noderockets/noderocket.org/README.md

# Your [DocPad](http://docpad.org) Project

## License
Copyright &copy; 2014+ All rights reserved.
