noderockets/noderocket.org/src/documents/rocket_control.html.md

---
title: "Node Rockets Rocket Control System"
layout: "default"
isPage: true
---

Rocket Control System
=======================

Goals
-----

The goals for the rocket control system are to:

1. Measure the altitude of the rocket.
2. Release a parachute.

Plans
-----

We're going to use a [BMP-180 module](http://www.adafruit.com/products/1603) to measure the altitude.  It's a barometric pressure sensor and altimeter.  The parachute will be released by turning a small servo motor.  Each of these components will be wired up to the Raspberry Pi's GPIO pins.

GPIO Pins
---------

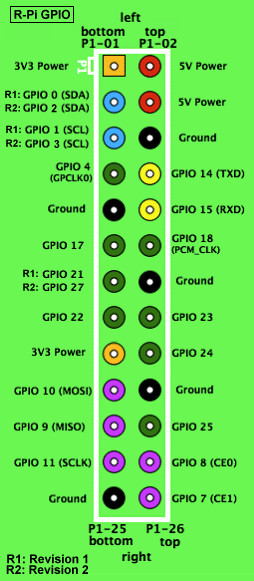
[picture p16: src/files/images/GPIOs.png]
Raspberry Pi GPIO Pins


The raspberry pi GPIO pins are laid out as shown above.  Numbering can be confusing, because it seems like different documents number the pins in different ways.  This diagram labels the entire GPIO header as P1, and numbers the pins on the left with odd numbers 1-25 and the pins on the right with even numbers 2-26.

Altimeter
---------

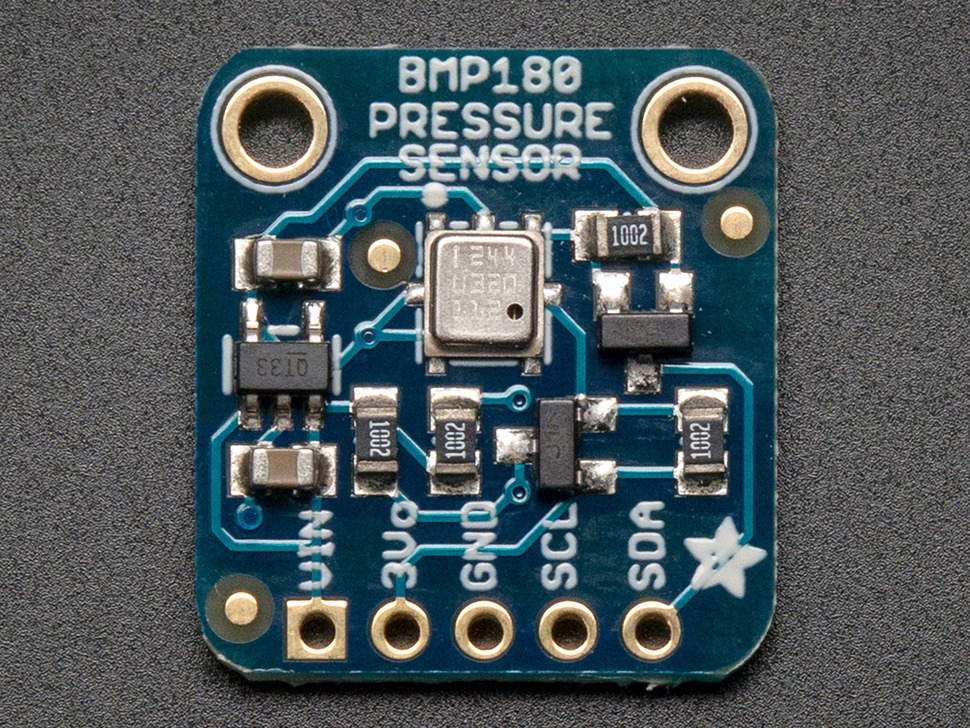
[picture p17: src/files/images/bmp180.jpg]
BMP-180


The BMP-180 uses [the I2C protocol](http://en.wikipedia.org/wiki/I%C2%B2C).  This protocol requires 4 connections: VIN (power), GND (ground), SCL (clock), and SDA (data).  The BMP-180 pins should be connected to these GPIO pins:

| BMP-180 | | GPIO |
|:---:| - |:----:|
| VIN | | 4 |
| GND | | 6 |
| SCL | | 5 |
| SDA | | 3 |

Here's what it looks like hooked up:

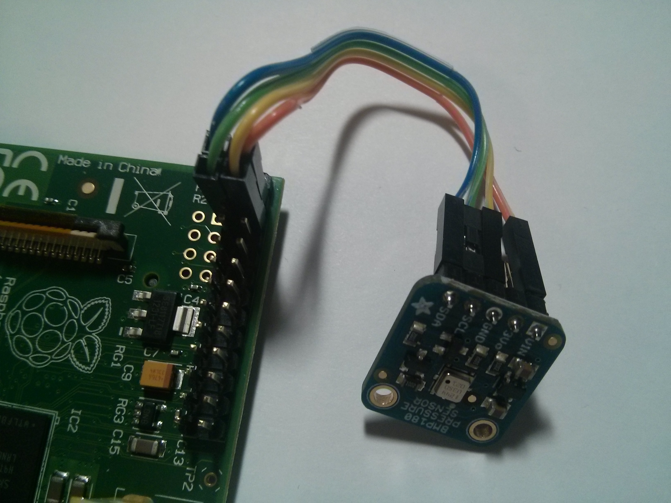
[picture p18: src/files/images/altimeter_pi.jpg]
Altimeter hooked up to Pi


Servo
-----

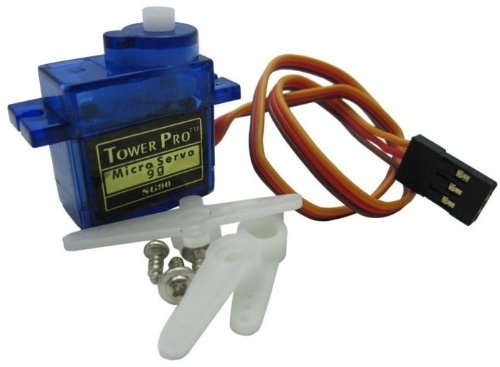
[picture p19: src/files/images/servo.jpg]
Servo


Servos have 3 wires: power, ground, and signal.  My servo uses the following color codes:

| Wire | | Color  |
| --- | - | --- |
| Power | | Red |
| Ground | | Brown  |
| Signal | | Orange |

The servo signal needs [pulse width modulation](http://en.wikipedia.org/wiki/Pulse-width_modulation) in order to control the servo's position correctly.  The raspberry pi supports hardware based PWM only on pin number 12, labeled "GPIO 18 (PCM_CLK)" on the diagram, so we'll use that one for the signal.  It is possible to use other pins using software PWM support.

The servo wires should be connected to these GPIO pins:

| Servo | | GPIO |
| --- | - | ---- |
| Power | | 2 |
| Ground | | 14 |
| Signal | | 12 |

Here's what it looks like hooked up:

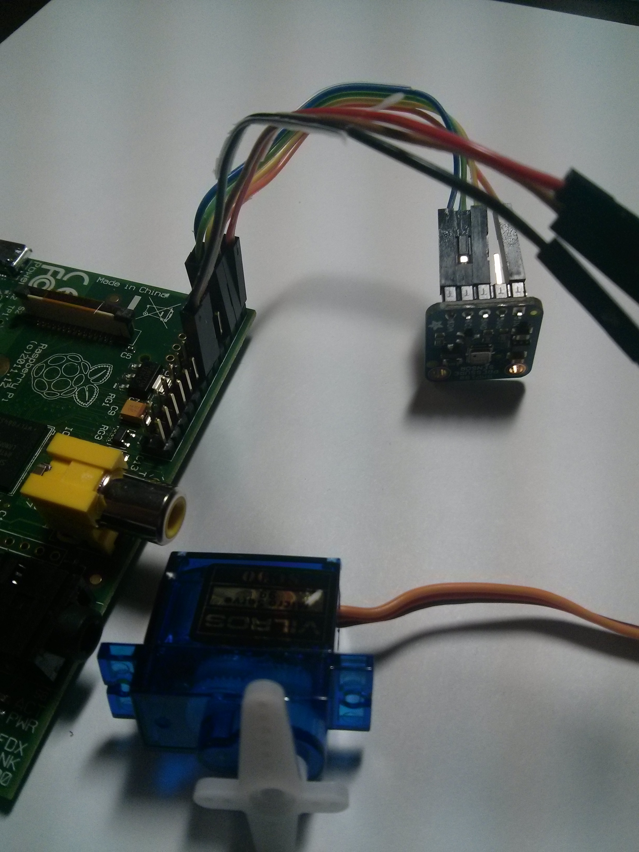
[picture p20: src/files/images/servo_pi.jpg]
Servo hooked up to Pi
