noderockets/noderocket.org/src/files/images/noderocket.png

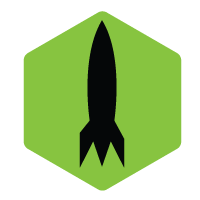
src/files/images/noderocket.png
