noderockets/noderocket.org/src/files/images/PFetSwitch.png

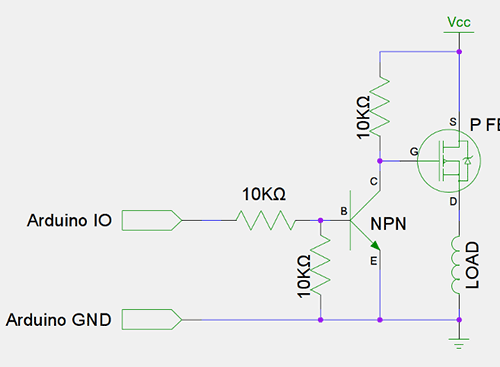
src/files/images/PFetSwitch.png
