noderockets/noderocket.org/src/files/images/rocket/empty-2liter.jpg

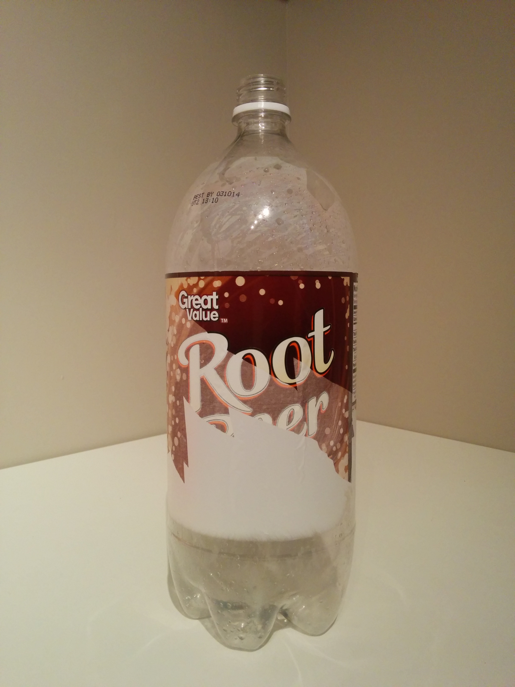
src/files/images/rocket/empty-2liter.jpg
