noderockets/noderocket.org/(list of files, drawings)

Other design files:
src/files/images/launcher_valve_schematic.fzz
src/files/images/noderocket-launcher_electronics.fzz
