noderockets/noderocket.org/(commit log)

2014-02-10 noderocket-launcher circuit layout fritzing
    [noderocket-launcher electronics.fzz]
2014-04-18 documentation for the launcher control mechanism
    [noderocket-launcher electronics.fzz, noderocket-launcher_electronics.fzz]
2014-06-01 Update launcher circuit documentation to address issues found during jsconf 2014. Pictures had wrong direction for NPN transistor. Barrel jack plug wasn't understood. Some teams plugged 15 V into Ard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
    [noderocket-launcher_electronics.fzz]
2014-06-01 Include links to actual parts. Improve parts lists. Improve valve circuit schematic.
    [launcher_valve_schematic.fzz]
